NicolasAuer08/Demo-Board/Hardware/Schematic/x.test - Demo Board.pdf

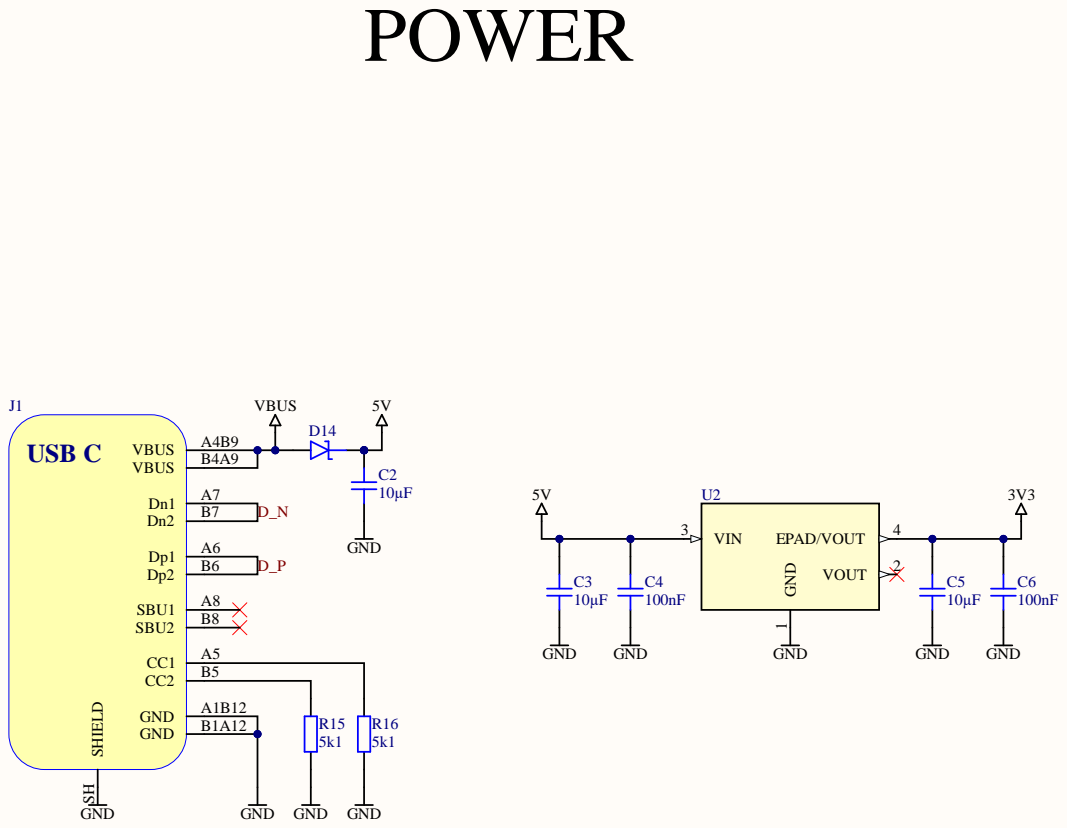
[picture p11: page 1]

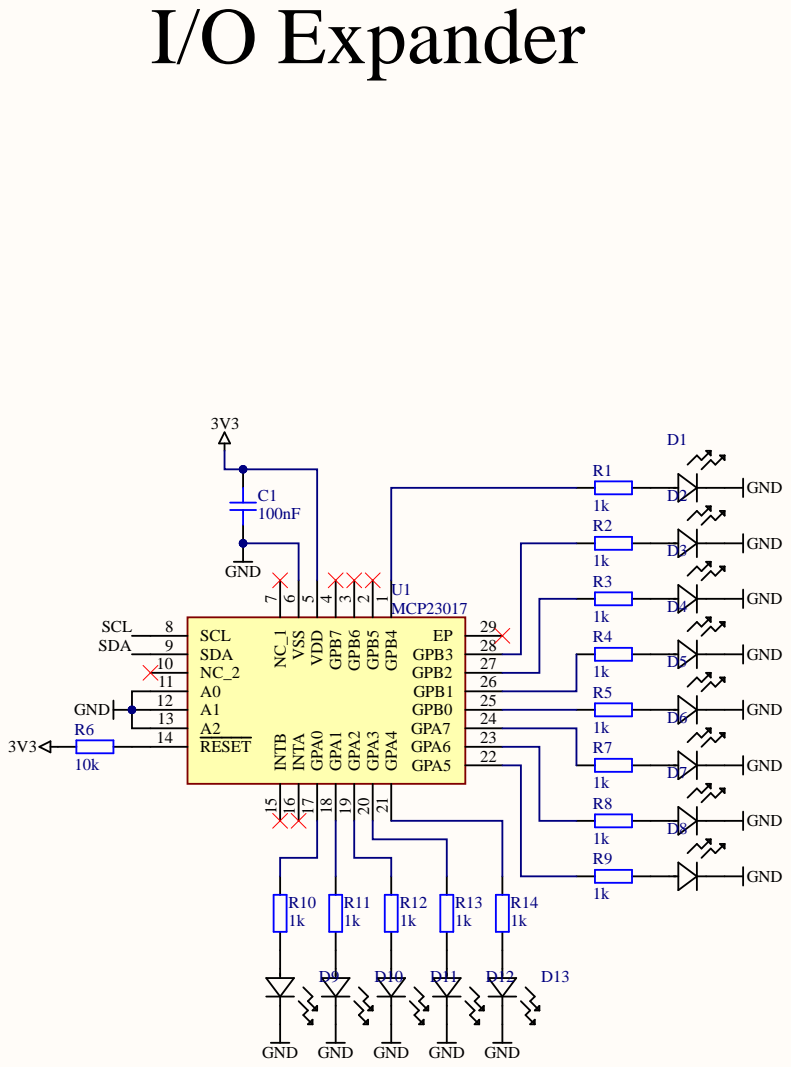
[picture p12: page 2]

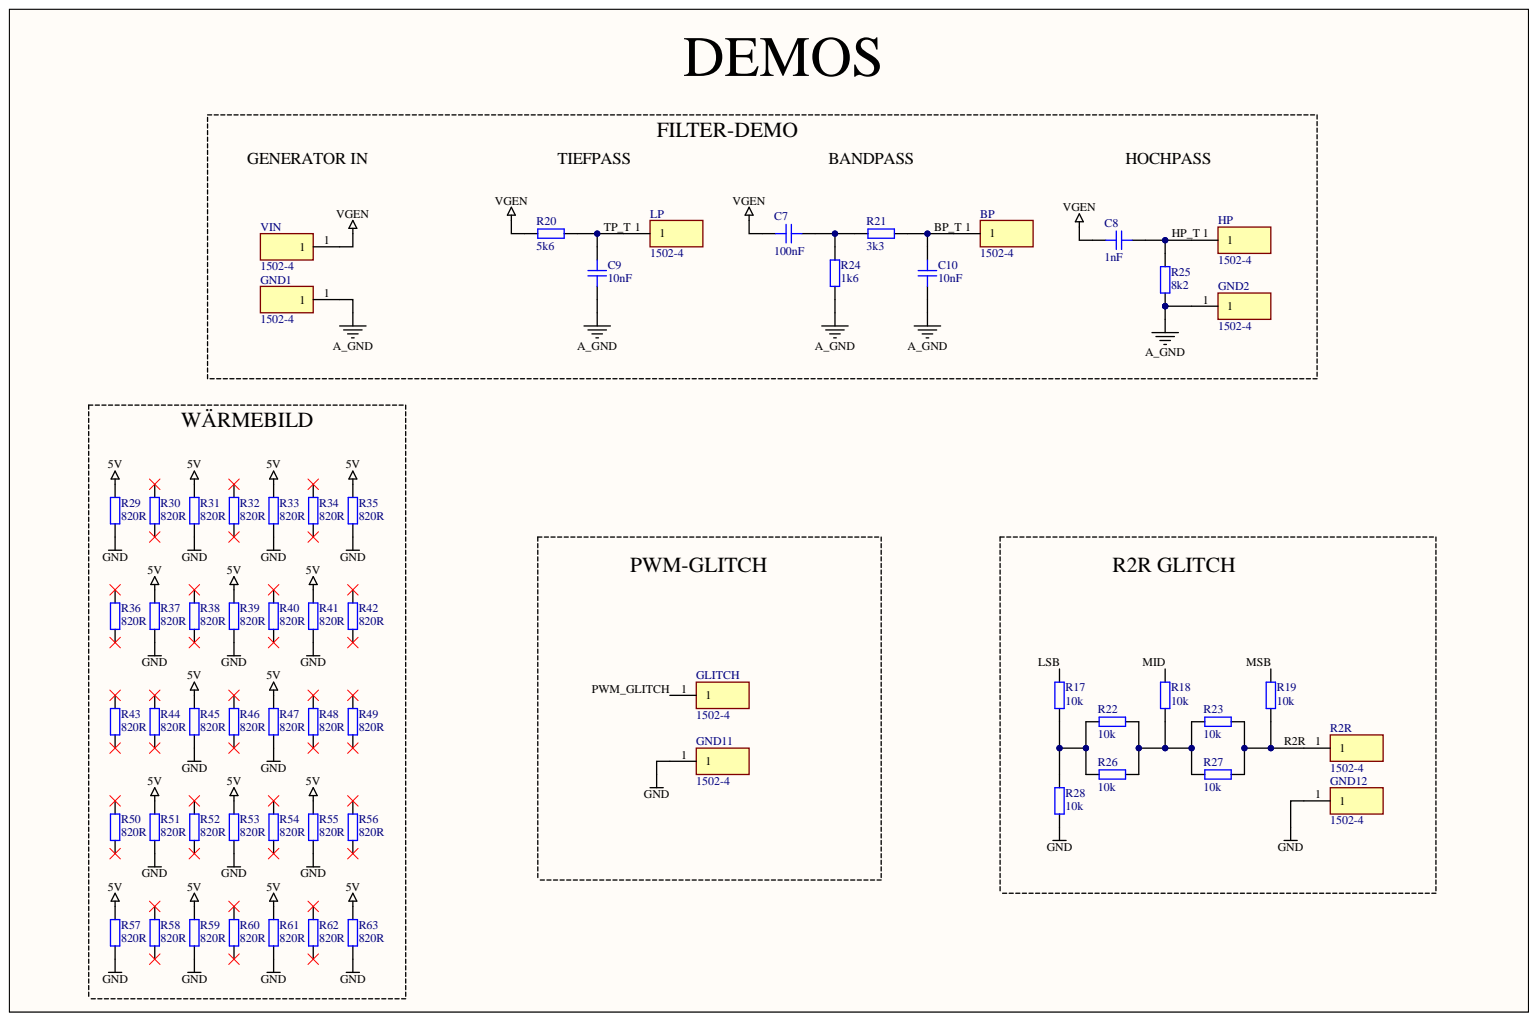
[picture p13: page 3]

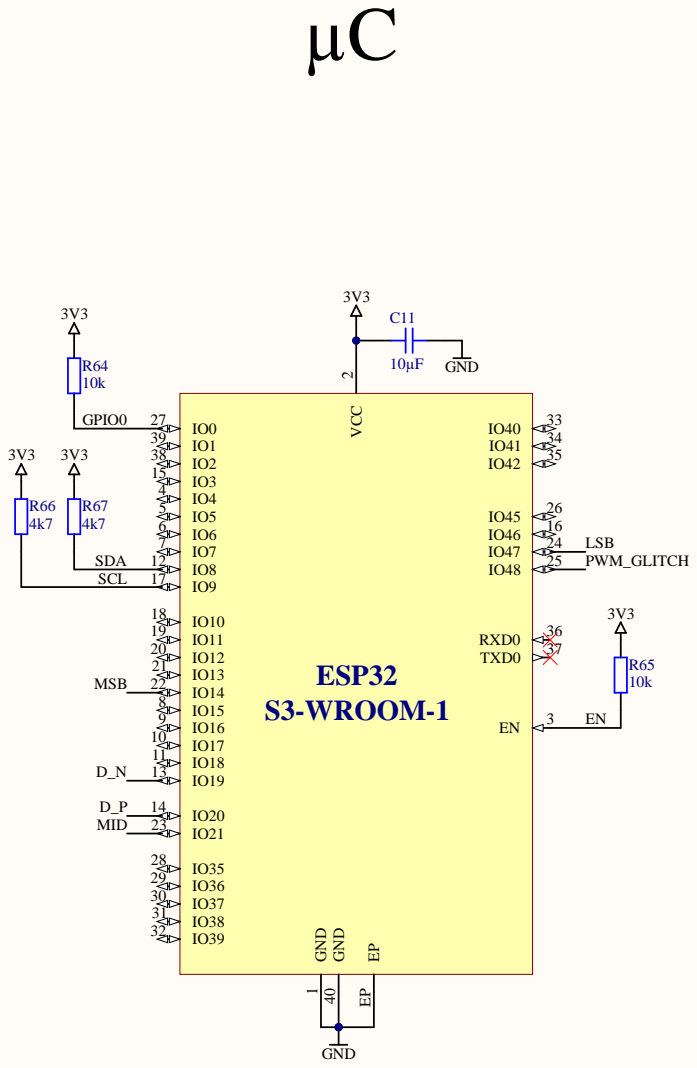
[picture p14: page 4]

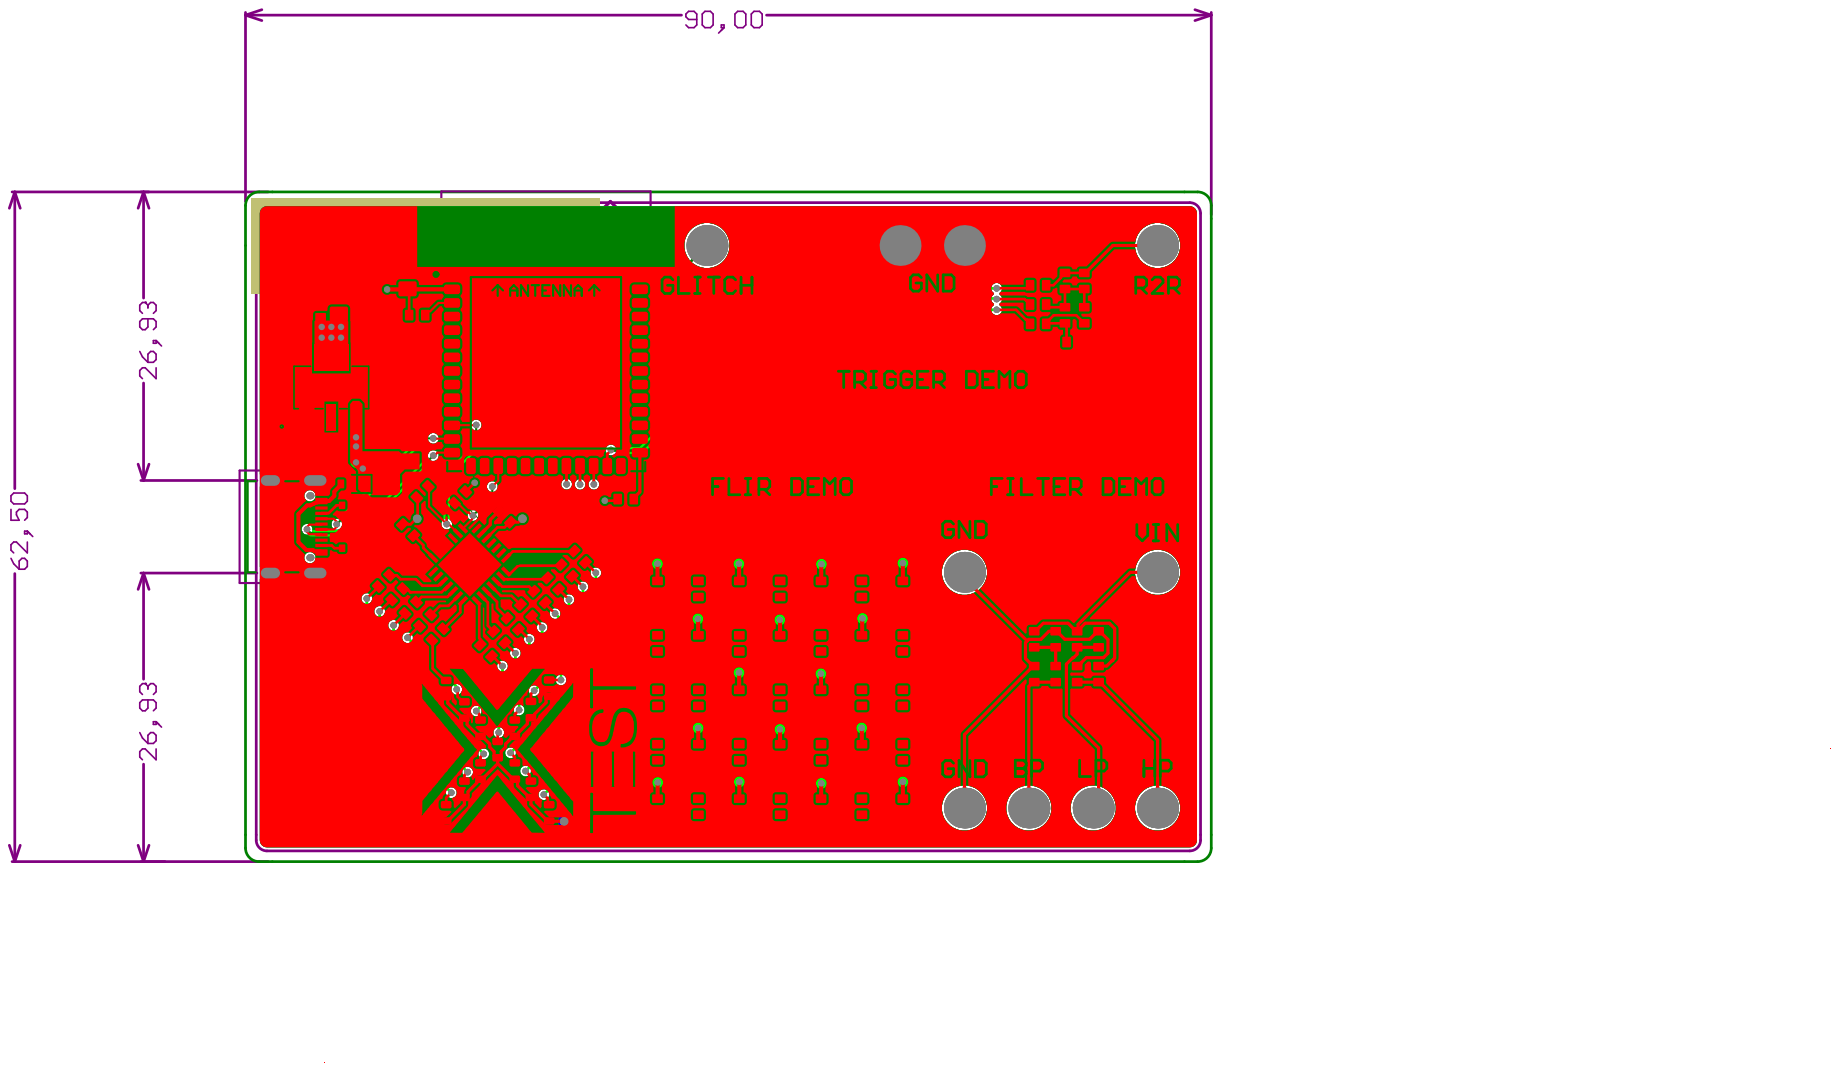
[picture p15: page 5]

Line# | Comment | Description | Designator | Quantity | TargetPrice | Manufacturer 1 | Manufacturer Part Number 1 | Manufacturer Lifecycle1 | Supplier 1 | Supplier Part Number 1 | Supplier Unit Price1 | Supplier Subtotal 1
1502-4 | | BP | 1
100nF | Capacitor SMD 0603 | C1 | 1
10µF | Capacitor SMD 0805 | C2 | 1
10µF | Capacitor SMD 0805 | C3 | 1
100nF | Capacitor SMD 0603 | C4 | 1
10µF | Capacitor SMD 0805 | C5 | 1
100nF | Capacitor SMD 0603 | C6 | 1
100nF | Capacitor SMD 0603 | C7 | 1
1nF | Capacitor SMD 0603 | C8 | 1
10nF | Capacitor SMD 0603 | C9 | 1
10nF | Capacitor SMD 0603 | C10 | 1
10µF | Capacitor SMD 0805 | C11 | 1
SML-310VTT86 | Description | D1 | 1
SML-310VTT86 SML-310VTT86 | Description Description | D2 D3 | 1 1
SML-310VTT86 | Description | D4 | 1
SML-310VTT86 | Description | D5 | 1
SML-310VTT86 | Description | D6 | 1
SML-310VTT86 | Description | D7 | 1
SML-310VTT86 SML-310VTT86 | Description Description | D8 D9 | 1 1
SML-310VTT86 | Description | D10 | 1
SML-310VTT86 | Description | D11 | 1
SML-310VTT86 | Description | D12 | 1
SML-310VTT86 | Description | D13 | 1
MS2A40LWS | DiodeSchottky SMDSOD-323, MS2A40LWS | D14 | 1
1502-4 | | GLITCH | 1
1502-4 | | GND1 | 1
1502-4 | | GND2 | 1
1502-4 | | GND11 | 1
1502-4 1502-4 | | GND12 HP | 1 1
USB4105-GF-A-060 USBConnector | TypeCSMT12Pin | J1 | 1
1502-4 | | LP | 1
1k | Resistor SMD0603 | R1 | 1
1k | Resistor SMD0603 | R2 | 1
1502-4 | | R2R | 1
1k | Resistor SMD0603 | R3 | 1
1k | Resistor SMD0603 | R4 | 1
1k | Resistor SMD0603 | R5 | 1
10k | Resistor SMD0603 | R6 | 1
1k | Resistor SMD0603 | R7 | 1
1k | Resistor SMD0603 | R8 | 1
1k | Resistor SMD0603 | R9 | 1
1k | Resistor SMD0603 | R10 | 1
1k | Resistor SMD0603 | R11 | 1
1k | Resistor SMD0603 | R12 | 1
1k | Resistor SMD0603 | R13 | 1
1k | Resistor SMD0603 | R14 | 1
5k1 | Resistor SMD0402 | R15 | 1
5k1 | Resistor SMD0402 | R16 | 1
10k | Resistor SMD0603 | R17 | 1
10k | Resistor SMD0603 | R18 | 1
10k | Resistor SMD0603 | R19 | 1
5k6 | Resistor SMD0603 | R20 | 1
3k3 | Resistor SMD0603 | R21 | 1
10k | Resistor SMD0603 | R22 | 1
10k | Resistor SMD0603 | R23 | 1
1k6 | Resistor SMD0603 | R24 | 1
8k2 | Resistor SMD0603 | R25 | 1
10k | Resistor SMD0603 | R26 | 1
10k | Resistor SMD0603 | R27 | 1
10k | Resistor SMD0603 | R28 | 1
820R | Resistor SMD0603 | R29 | 1
820R | Resistor SMD0603 | R30 | 1
820R | Resistor SMD0603 | R31 | 1
820R | Resistor SMD0603 | R32 | 1
820R | Resistor SMD0603 | R33 | 1
820R | Resistor SMD0603 | R34 | 1
820R | Resistor SMD0603 | R35 | 1
820R | Resistor SMD0603 | R36 | 1
820R | Resistor SMD0603 | R37 | 1
820R | Resistor SMD0603 | R38 | 1
820R | Resistor SMD0603 | R39 | 1
820R | Resistor SMD0603 | R40 | 1
820R | Resistor SMD0603 | R41 | 1
820R | Resistor SMD0603 | R42 | 1
820R | Resistor SMD0603 | R43 | 1
820R | Resistor SMD0603 | R44 | 1
820R | Resistor SMD0603 | R45 | 1
820R | Resistor SMD0603 | R46 | 1
820R | Resistor SMD0603 | R47 | 1
820R | Resistor SMD0603 | R48 | 1
820R | Resistor SMD0603 | R49 | 1
820R | Resistor SMD0603 | R50 | 1
820R | Resistor SMD0603 | R51 | 1
820R | Resistor SMD0603 | R52 | 1
820R | Resistor SMD0603 | R53 | 1
820R | Resistor SMD0603 | R54 | 1
820R | Resistor SMD0603 | R55 | 1
820R | Resistor SMD0603 | R56 | 1
820R | Resistor SMD0603 | R57 | 1
820R | Resistor SMD0603 | R58 | 1
820R | Resistor SMD0603 | R59 | 1
820R | Resistor SMD0603 | R60 | 1
820R | Resistor SMD0603 | R61 | 1
820R | Resistor SMD0603 | R62 | 1
820R | Resistor SMD0603 | R63 | 1
10k | Resistor SMD0603 | R64 | 1
10k | Resistor SMD0603 | R65 | 1
4k7 | Resistor SMD0603 | R66 | 1
4k7 | Resistor SMD0603 | R67 | 1
MCP23017 | Integrated Circuit | U1 | 1
AMS1117-3.3 | Description | U2 | 1
ESP32-S3-WROOM-1-N8 | 2.4GHzWi-Fi (802.11b/g/n) and Bluetooth 5(LE) ModuleESP32-S3, 4MBFlash, on-board PCB antenna) | U3 | 1
1502-4 | | VIN | 1
