NicolasAuer08/Demo-Board/(list of files, drawings)

Other design files:
Hardware/Projekt Files (Altium)/Demo Board 1 - Schematic.SchDoc
Hardware/Projekt Files (Altium)/Demo Board 2- Schematic.SchDoc
Hardware/Projekt Files (Altium)/Demo Board 3 - Schematic.SchDoc
Hardware/Projekt Files (Altium)/Demo Board 4 - Schematic.SchDoc
Hardware/Projekt Files (Altium)/Demo Board - PCB.PcbDoc
Hardware/Projekt Files (Altium)/x.test - Demo Board.PrjPcb
